samruddhashastry030/navic-sips/matlab/out/kpi_sweep_fixed.png

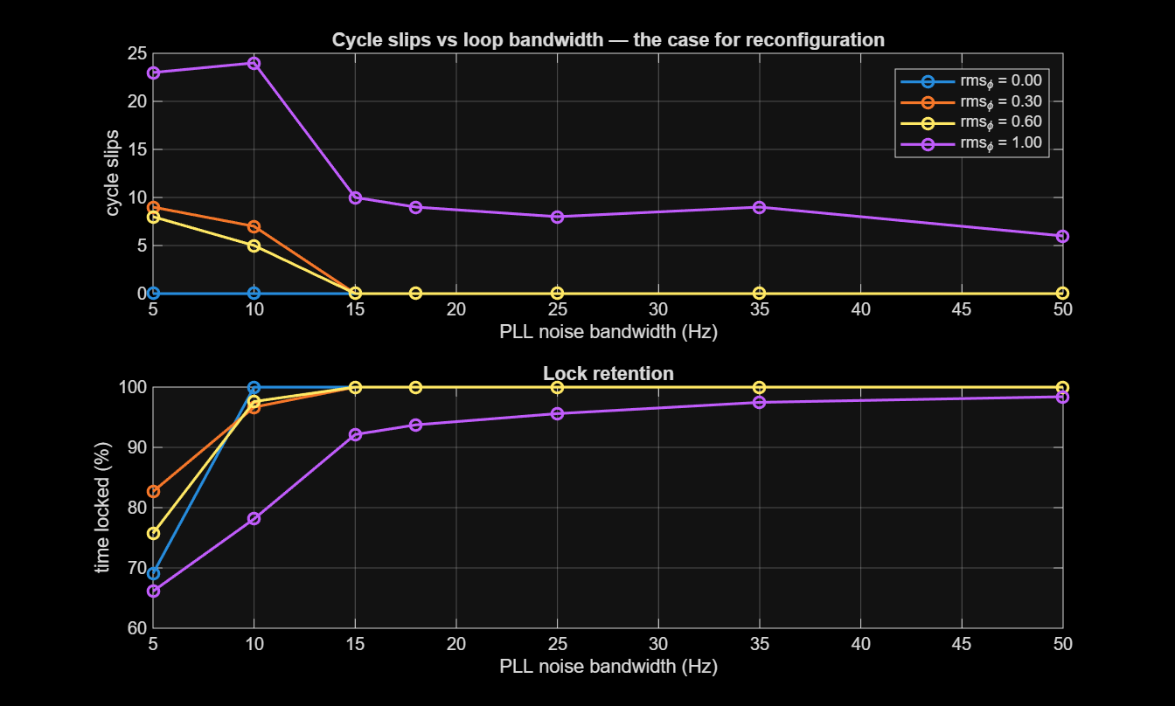
matlab/out/kpi_sweep_fixed.png
