samruddhashastry030/navic-sips/matlab/Q.png

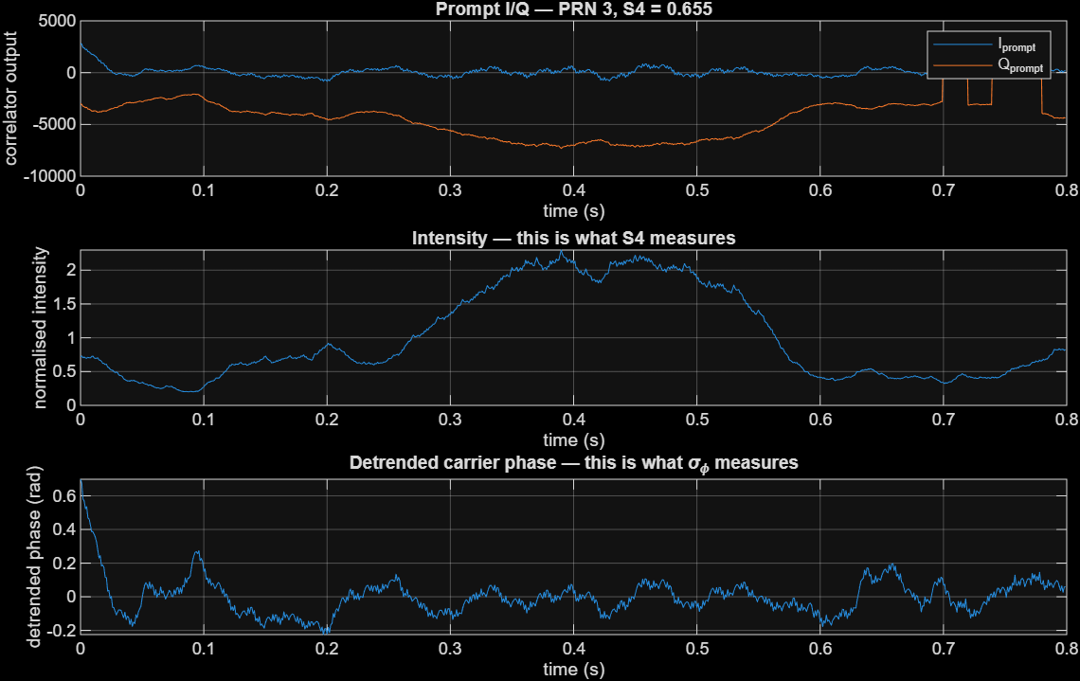
matlab/Q.png
