samruddhashastry030/navic-sips/matlab/out/kpi_results.csv

scint | bw | S4 | sigmaPhi | cycleSlips | lockFraction | meanCN0
0 | 5 | 0.0327298286688911 | 0.198362843854568 | 0 | 0.690666666666667 | 30.8938444919024
0 | 10 | 0.0327298286688877 | 0.11101728670671 | 0 | 1 | 33.5103716137767
0 | 15 | 0.0327298286688911 | 0.0923495164488063 | 0 | 1 | 33.6596927661663
0 | 18 | 0.0327298286688877 | 0.0837995596693963 | 0 | 1 | 33.6881438489789
0 | 25 | 0.0327298286688911 | 0.0630737580233704 | 0 | 1 | 33.7408337658369
0 | 35 | 0.0327298286688911 | 0.0431269650917404 | 0 | 1 | 33.7768762955005
0 | 50 | 0.0327298286688877 | 0.0340538441725248 | 0 | 1 | 33.7884648013822
0.3 | 5 | 0.330350867427098 | 0.389840134931066 | 9 | 0.826666666666667 | 30.9692741234643
0.3 | 10 | 0.330350867427096 | 0.245924950568542 | 7 | 0.966666666666667 | 32.3437781036556
0.3 | 15 | 0.330350867427096 | 0.146402988311347 | 0 | 1 | 32.935034015576
0.3 | 18 | 0.330350867427096 | 0.113757604458473 | 0 | 1 | 33.0636342401715
0.3 | 25 | 0.330350867427096 | 0.0742774789065409 | 0 | 1 | 33.1738159977029
0.3 | 35 | 0.330350867427095 | 0.05142006617363 | 0 | 1 | 33.2161570244355
0.3 | 50 | 0.330350867427097 | 0.0393446608640148 | 0 | 1 | 33.2320506783475
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
