samruddhashastry030/navic-sips/tb/system/tb_system_spi.sv

// tb_system_spi.sv -- the whole control and signal path as real RTL.
//
// Real PicoRV32, soc_bus, firmware, SICU, LSTM accelerator AND spi_master,
// which drives CS/SCLK/MOSI/MISO pins into a bit-level SPI flash model
// (mode 0, 0x03 READ, 24-bit address, auto-increment). Only the flash chip,
// the I/Q source and the SRAM macros are behavioural.
//
// Built with +define+BAD_FLASH it loads a corrupted image and checks the
// retry path at pin level: the flash must see three separately framed READ
// commands, which proves chip-select really rises between bursts.
//
// Earlier description, still applicable:
// tb_system_sicu.sv -- end-to-end run with the REAL SICU and REAL accelerator.
//
// The SICU is fed synthetic prompt I/Q: a slowly rotating carrier phase with
// amplitude scintillation whose depth ramps up window by window, so S4 climbs
// from quiet to disturbed. Each window's S4 is checked against S4 computed in
// floating point from the exact same integer samples.
//
// Otherwise as tb_system_accel.sv:
//
// Same as tb_system.sv, but the accelerator model is replaced by two copies of
// the verified lstm_accel:
//   u_acc  in the system: reads weights the CPU loaded over SPI into the
//          weight SRAM (port 1), fed timesteps by the firmware through soc_bus
//   u_ref  reference: reads the weight image straight from the file, fed the
//          identical timesteps on the identical cycles
// Both are the same RTL, already bit-exact against the golden vectors, so any
// difference in their logits can only come from integration.
//
// Real PicoRV32 (RV32IMC, as hardened), real soc_bus, real firmware from the
// boot ROM. Behavioural models stand in for:
//   - SPI flash      byte-level: answers each spi_start with the next byte
//   - SICU           pulses a new S4 every SICU_PERIOD cycles once enabled
//   - accelerator    accepts 32 timesteps, then returns fixed logits
// The SRAMs are modelled with a registered output like the SKY130 macros.
//
// Checks that the firmware boots, loads and verifies all 512 weight words,
// feeds the accelerator 32 correctly normalised timesteps in order, and
// publishes the class, loop settings and weights_ready it should.
`timescale 1ns/1ps
`default_nettype none
module tb_system_spi;
  localparam SICU_PERIOD = 4000;

  reg clk = 0, rst_n = 0;
  always #5 clk = ~clk;

  // ---- CPU ----------------------------------------------------------------
  wire        mem_valid, mem_instr, mem_ready, trap;
  wire [31:0] mem_addr, mem_wdata, mem_rdata;
  wire [ 3:0] mem_wstrb;

  picorv32 #(
    .ENABLE_MUL(1), .ENABLE_DIV(1), .COMPRESSED_ISA(1), .ENABLE_IRQ(1),
    .ENABLE_COUNTERS64(0),
    .PROGADDR_RESET(32'h0000_0000), .PROGADDR_IRQ(32'h0000_0010)
  ) u_cpu (
    .clk(clk), .resetn(rst_n), .trap(trap),
    .mem_valid(mem_valid), .mem_instr(mem_instr), .mem_ready(mem_ready),
    .mem_addr(mem_addr), .mem_wdata(mem_wdata), .mem_wstrb(mem_wstrb),
    .mem_rdata(mem_rdata),
    .mem_la_read(), .mem_la_write(), .mem_la_addr(), .mem_la_wdata(),
    .mem_la_wstrb(),
    .pcpi_valid(), .pcpi_insn(), .pcpi_rs1(), .pcpi_rs2(),
    .pcpi_wr(1'b0), .pcpi_rd(32'd0), .pcpi_wait(1'b0), .pcpi_ready(1'b0),
    .irq(32'd0), .eoi(), .trace_valid(), .trace_data()
  );

  // ---- bus + peripheral wires ---------------------------------------------
  wire dram_csb, dram_web, wram_csb, wram_web;
  wire [3:0] dram_wmask, wram_wmask; wire [7:0] dram_addr; wire [8:0] wram_addr;
  wire [31:0] dram_din, wram_din; reg [31:0] dram_dout = 0, wram_dout = 0;

  wire weights_ready, weights_fault, bist_done, bist_pass, loop_fll_en;
  wire [1:0] pred_class, loop_band_pref; wire [3:0] pred_conf;
  wire [2:0] loop_pll_bw, loop_t_coh; wire [15:0] s4_report;

  wire spi_start, spi_hold_cs; wire [7:0] spi_tx; reg [7:0] spi_rx;
  reg spi_done;
  wire uart_valid; wire [7:0] uart_data;

  wire sicu_enable; reg sicu_s4_valid; reg [15:0] sicu_s4;
  wire accel_start, accel_in_valid, accel_in_ready, accel_out_valid, accel_busy;
  wire [15:0] feat0, feat1;
  wire signed [15:0] l0, l1, l2; wire [1:0] acls;

  soc_bus #(.FW_HEX("firmware.hex")) u_bus (
    .clk_i(clk), .rst_ni(rst_n),
    .mem_valid_i(mem_valid), .mem_ready_o(mem_ready), .mem_addr_i(mem_addr),
    .mem_wdata_i(mem_wdata), .mem_wstrb_i(mem_wstrb), .mem_rdata_o(mem_rdata),
    .dram_csb_o(dram_csb), .dram_web_o(dram_web), .dram_wmask_o(dram_wmask),
    .dram_addr_o(dram_addr), .dram_din_o(dram_din), .dram_dout_i(dram_dout),
    .wram_csb_o(wram_csb), .wram_web_o(wram_web), .wram_wmask_o(wram_wmask),
    .wram_addr_o(wram_addr), .wram_din_o(wram_din), .wram_dout_i(wram_dout),
    .weights_ready_o(weights_ready), .weights_fault_o(weights_fault),
    .bist_done_o(bist_done), .bist_pass_o(bist_pass),
    .pred_class_o(pred_class), .pred_conf_o(pred_conf),
    .loop_pll_bw_o(loop_pll_bw), .loop_fll_en_o(loop_fll_en),
    .loop_t_coh_o(loop_t_coh), .loop_band_pref_o(loop_band_pref),
    .s4_report_o(s4_report), .host_ctrl_i(4'd0),
    .spi_start_o(spi_start), .spi_hold_cs_o(spi_hold_cs), .spi_tx_o(spi_tx),
    .spi_rx_i(spi_rx), .spi_done_i(spi_done),
    .uart_valid_o(uart_valid), .uart_data_o(uart_data), .uart_busy_i(1'b0),
    .sicu_enable_o(sicu_enable), .sicu_s4_valid_i(sicu_s4_valid),
    .sicu_s4_i(sicu_s4), .sicu_saturated_i(sicu_saturated_w),
    .sicu_shift_i(sicu_shift_w), .sicu_busy_i(sicu_busy_w),
    .accel_start_o(accel_start), .accel_busy_i(accel_busy),
    .accel_in_valid_o(accel_in_valid), .accel_in_ready_i(accel_in_ready),
    .accel_feat0_o(feat0), .accel_feat1_o(feat1),
    .accel_out_valid_i(accel_out_valid), .accel_logit0_i(l0),
    .accel_logit1_i(l1), .accel_logit2_i(l2), .accel_class_i(acls));

  // ---- SRAM models ---------------------------------------------------------
  reg [31:0] dmem [0:255], wmem [0:511];
  integer k;
  always @(posedge clk) begin
    if (!dram_csb) begin
      if (!dram_web) for (k = 0; k < 4; k = k + 1)
        begin if (dram_wmask[k]) dmem[dram_addr][8*k +: 8] <= dram_din[8*k +: 8]; end
      else dram_dout <= dmem[dram_addr];
    end
    if (!wram_csb) begin
      if (!wram_web) for (k = 0; k < 4; k = k + 1)
        begin if (wram_wmask[k]) wmem[wram_addr][8*k +: 8] <= wram_din[8*k +: 8]; end
      else wram_dout <= wmem[wram_addr];
    end
    if (!acc_w_csb) acc_w_dout <= wmem[acc_w_addr];      // port 1, read only
    if (!ref_w_csb) ref_w_dout <= refmem[ref_w_addr];
  end

  // ---- the real accelerator, and its reference twin ------------------------
  wire acc_w_csb, ref_w_csb; wire [8:0] acc_w_addr, ref_w_addr;
  reg  [31:0] acc_w_dout = 0, ref_w_dout = 0;
  reg  [31:0] refmem [0:511];
  initial $readmemh("wimage.hex", refmem);

  lstm_accel #(.LUT_SIG("lut_sigmoid.hex"), .LUT_TANH("lut_tanh.hex")) u_acc (
    .clk_i(clk), .rst_ni(rst_n),
    .start_i(accel_start), .busy_o(accel_busy),
    .in_valid_i(accel_in_valid), .in_ready_o(accel_in_ready),
    .in_feat0_i(feat0), .in_feat1_i(feat1),
    .w_csb_o(acc_w_csb), .w_addr_o(acc_w_addr), .w_dout_i(acc_w_dout),
    .out_valid_o(accel_out_valid),
    .logit0_o(l0), .logit1_o(l1), .logit2_o(l2), .class_o(acls));

  wire ref_ready, ref_valid, ref_busy; wire signed [15:0] r0, r1, r2; wire [1:0] rcls;
  lstm_accel #(.LUT_SIG("lut_sigmoid.hex"), .LUT_TANH("lut_tanh.hex")) u_ref (
    .clk_i(clk), .rst_ni(rst_n),
    .start_i(accel_start), .busy_o(ref_busy),
    .in_valid_i(accel_in_valid), .in_ready_o(ref_ready),
    .in_feat0_i(feat0), .in_feat1_i(feat1),
    .w_csb_o(ref_w_csb), .w_addr_o(ref_w_addr), .w_dout_i(ref_w_dout),
    .out_valid_o(ref_valid),
    .logit0_o(r0), .logit1_o(r1), .logit2_o(r2), .class_o(rcls));

  // ---- REAL SPI master ------------------------------------------------------
  // clk_div 1: SCLK = clk / 4 -- 8.25 MHz at 33 MHz, well inside what any
  // flash part supports for a plain 0x03 READ.
  wire spi_cs_n, spi_sclk, spi_mosi, spi_miso;
  wire spi_busy_w;
  wire [7:0] spi_rx_w; wire spi_done_w;
  spi_master #(.DIV_WIDTH(8), .DATA_WIDTH(8)) u_spi (
    .clk_i(clk), .rst_ni(rst_n), .clk_div_i(8'd1),
    .start_i(spi_start), .hold_cs_i(spi_hold_cs), .tx_data_i(spi_tx),
    .rx_data_o(spi_rx_w), .busy_o(spi_busy_w), .done_o(spi_done_w),
    .cs_no(spi_cs_n), .sclk_o(spi_sclk), .mosi_o(spi_mosi), .miso_i(spi_miso));
  always @(*) begin spi_rx = spi_rx_w; spi_done = spi_done_w; end

  integer n_spi = 0;
  always @(posedge clk) if (spi_start) n_spi = n_spi + 1;

  // ---- bit-level SPI flash: mode 0, 0x03 READ, full 24-bit address ----------
  // Structure follows tb/tb_spi_master.sv; extended from 256 bytes to the full
  // image, and it counts every command so framing can be checked.
  reg [7:0]  flash [0:4095];
  reg [7:0]  f_shift_in, f_shift_out;
  reg [2:0]  f_bitcnt;
  reg [7:0]  f_cmd;
  reg [23:0] f_addr;
  reg [2:0]  f_state;           // 0 cmd, 1..3 addr, 4 data
  reg        f_miso;
  integer    n_cmd = 0, n_bad_cmd = 0, n_cs_fall = 0;
  assign spi_miso = spi_cs_n ? 1'bz : f_miso;
  initial begin
    for (k = 0; k < 4096; k = k + 1) flash[k] = 8'hFF;
`ifdef BAD_FLASH
    $readmemh("flash_bad.hex", flash);
`else
    $readmemh("flash.hex", flash);
`endif
  end
  always @(negedge spi_cs_n) begin
    f_bitcnt <= 0; f_state <= 0; f_shift_in <= 0; f_miso <= 1'b0;
    n_cs_fall = n_cs_fall + 1;
  end
  always @(posedge spi_sclk) if (!spi_cs_n) begin
    f_shift_in <= {f_shift_in[6:0], spi_mosi};
    if (f_bitcnt == 3'd7) begin
      case (f_state)
        3'd0: begin
          f_cmd <= {f_shift_in[6:0], spi_mosi}; f_state <= 1;
          n_cmd = n_cmd + 1;
          if ({f_shift_in[6:0], spi_mosi} !== 8'h03) n_bad_cmd = n_bad_cmd + 1;
        end
        3'd1: begin f_addr[23:16] <= {f_shift_in[6:0], spi_mosi}; f_state <= 2; end
        3'd2: begin f_addr[15:8]  <= {f_shift_in[6:0], spi_mosi}; f_state <= 3; end
        3'd3: begin f_addr[7:0]   <= {f_shift_in[6:0], spi_mosi}; f_state <= 4; end
        default: f_addr <= f_addr + 1;
      endcase
      f_bitcnt <= 0;
    end else f_bitcnt <= f_bitcnt + 1;
  end
  always @(negedge spi_sclk) if (!spi_cs_n) begin
    if (f_state == 4) begin
      if (f_bitcnt == 0) begin
        f_shift_out <= flash[f_addr[11:0]];
        f_miso      <= flash[f_addr[11:0]][7];
      end else f_miso <= f_shift_out[6-(f_bitcnt-1)];
    end else f_miso <= 1'b0;
  end

  // ---- REAL SICU, fed synthetic I/Q --------------------------------------
  localparam SAMPLE_GAP = 8;          // cycles between samples offered
  localparam WIN_N      = 500;

  reg  signed [15:0] iq_i = 0, iq_q = 0;
  reg                iq_valid = 0;
  wire               iq_ready, sicu_saturated_w, sicu_busy_w, sicu_s4_valid_w;
  wire        [15:0] sicu_s4_w;
  wire        [ 4:0] sicu_shift_w;

  sicu u_sicu (
    .clk_i(clk), .rst_ni(rst_n), .enable_i(sicu_enable), .busy_o(sicu_busy_w),
    .in_valid_i(iq_valid), .in_ready_o(iq_ready), .i_i(iq_i), .q_i(iq_q),
    .s4_valid_o(sicu_s4_valid_w), .s4_o(sicu_s4_w),
    .saturated_o(sicu_saturated_w), .shift_o(sicu_shift_w));

  // Deterministic pseudo-random scintillation. Depth d ramps per window;
  // amplitude a = A * (1 + d * r), r uniform in [-1, 1).
  reg  [31:0] lfsr = 32'hACE1_2468;
  integer     gap = 0, n_samp = 0, n_windows = 0, cyc_w32 = 0;
  real        amp, phase = 0.0, depth, r, inten, s1 = 0, s2 = 0;
  real        s4_ref [0:63];
  reg  [15:0] s4_hw  [0:63];
  reg         sat_hw [0:63];
  reg  [ 4:0] shf_hw [0:63];

  always @(posedge clk) begin
    if (iq_valid && iq_ready) begin
      // accumulate the float reference on exactly the samples accepted
      inten = $itor(iq_i) * $itor(iq_i) + $itor(iq_q) * $itor(iq_q);
      s1 = s1 + inten; s2 = s2 + inten * inten;
      n_samp = n_samp + 1;
      if (n_samp == WIN_N) begin
        if (n_windows < 64)
          s4_ref[n_windows] = $sqrt((WIN_N * s2) / (s1 * s1) - 1.0);
        s1 = 0; s2 = 0; n_samp = 0;
      end
      iq_valid <= 0;
      gap = 0;
    end else if (!iq_valid && sicu_enable) begin
      gap = gap + 1;
      if (gap >= SAMPLE_GAP) begin
        lfsr  = {lfsr[30:0], lfsr[31] ^ lfsr[21] ^ lfsr[1] ^ lfsr[0]};
        r     = ($itor(lfsr[15:0]) / 32768.0) - 1.0;
        depth = 0.02 + 0.010 * n_windows;
        amp   = 1200.0 * (1.0 + depth * r);
        phase = phase + 0.013;
        iq_i  <= $rtoi(amp * $cos(phase));
        iq_q  <= $rtoi(amp * $sin(phase));
        iq_valid <= 1;
      end
    end
    if (sicu_s4_valid_w) begin
      if (n_windows < 64) begin
        s4_hw[n_windows]  = sicu_s4_w;
        sat_hw[n_windows] = sicu_saturated_w;
        shf_hw[n_windows] = sicu_shift_w;
      end
      n_windows = n_windows + 1;
      if (n_windows == 32) cyc_w32 = cyc;
    end
  end

  // Feed the bus from the real block.
  always @(*) begin
    sicu_s4_valid = sicu_s4_valid_w;
    sicu_s4       = sicu_s4_w;
  end

  // ---- record what the firmware feeds, and when each accelerator finishes --
  integer n_feat = 0, n_starts = 0, lockstep_err = 0;
  reg [15:0] got_feat [0:31];
  reg signed [15:0] sys_l [0:2], ref_l [0:2];
  reg sys_done = 0, ref_done = 0;
  always @(posedge clk) begin
    if (accel_start) n_starts = n_starts + 1;
    if (accel_in_valid && accel_in_ready) begin
      if (n_feat < 32) got_feat[n_feat] = feat0;
      n_feat = n_feat + 1;
    end
    if (accel_in_ready !== ref_ready) lockstep_err = lockstep_err + 1;
    if (accel_out_valid && !sys_done) begin
      sys_l[0] = l0; sys_l[1] = l1; sys_l[2] = l2; sys_done = 1;
    end
    if (ref_valid && !ref_done) begin
      ref_l[0] = r0; ref_l[1] = r1; ref_l[2] = r2; ref_done = 1;
    end
  end

  // ---- checks -------------------------------------------------------------
  integer errors = 0, cyc = 0;
  reg [31:0] wexp [0:511];
  // mu and 1/sd come from the header of the image under test, not constants:
  // the real exported weights carry different values from any test image.
  integer mu_g, invsd_g;
  function automatic signed [15:0] norm(input [15:0] s4);
    integer q88, d, o;
    begin
      q88 = (s4 + 8) >>> 4;
      d   = q88 - mu_g;
      o   = (d * invsd_g + 128) >>> 8;
      if (o >  32767) o =  32767;
      if (o < -32768) o = -32768;
      norm = o[15:0];
    end
  endfunction

  always @(posedge clk) begin
    cyc = cyc + 1;
    if (trap) begin
      $display("FAIL  CPU trapped at cycle %0d, pc near %h", cyc, mem_addr);
      errors = errors + 1; $finish;
    end
  end

`ifndef BAD_FLASH
  initial begin
    $readmemh("wimage.hex", wexp);
    mu_g    = $signed(wexp[0][15:0]);
    invsd_g = $signed(wexp[1][15:0]);
    $display("       header: mu = %0d/256, 1/sd = %0d/256", mu_g, invsd_g);
    repeat (5) @(posedge clk); rst_n = 1;

    wait (sicu_enable === 1'b1);
    $display("cycle %0d  firmware reached the main loop (%0d SPI bytes)", cyc, n_spi);
    for (k = 0; k < 512; k = k + 1)
      if (wmem[k] !== wexp[k]) begin
        if (errors < 5) $display("FAIL  weight word %0d: %h != %h", k, wmem[k], wexp[k]);
        errors = errors + 1;
      end
    if (errors == 0) $display("pass  all 512 weight words loaded and match");
    $display("       flash saw %0d command(s), %0d CS falls, %0d not 0x03", n_cmd, n_cs_fall, n_bad_cmd);
    if (n_cmd != 1 || n_bad_cmd != 0 || f_addr === 24'hx) begin
      $display("FAIL  expected exactly one 0x03 READ"); errors = errors + 1;
    end else $display("pass  one framed 0x03 READ, burst of %0d bytes on the pins", n_spi - 4);
    if (weights_fault) begin $display("FAIL  firmware reported weight fault"); errors = errors + 1; end
    else $display("pass  checksum accepted, no fault");
    if (weights_ready) begin $display("FAIL  ready asserted before first result"); errors = errors + 1; end
    else $display("pass  not ready during cold start");

    wait (weights_ready === 1'b1);
    $display("cycle %0d  first result published", cyc);
    $display("       inference latency: %0d cycles from the 32nd window to the result", cyc - cyc_w32);
    $display("       = %0.2f ms at 33 MHz, against a 10 s window", (cyc - cyc_w32) / 33000.0);
    if (n_windows < 32) begin $display("FAIL  result before 32 windows"); errors = errors + 1; end
    if (n_starts != 1)   begin $display("FAIL  %0d accelerator starts", n_starts); errors = errors + 1; end
    begin : sicu_checks
      integer w, worst_w, n_sat;
      real err, worst;
      reg [15:0] pushed [0:31];
      reg [15:0] last;
      worst = 0.0; worst_w = 0; n_sat = 0; last = 0;
      $display("       window  shift  sat   S4 hw    S4 float   error");
      begin : ring
        integer np;
        np = 0;
        for (w = 0; w < 64 && np < 32; w = w + 1) begin
          if (w < 4 || w % 8 == 7)
            $display("       %4d    %3d    %0d   %6.4f   %6.4f   %+7.4f", w, shf_hw[w],
                     sat_hw[w], s4_hw[w] / 4096.0, s4_ref[w], s4_hw[w] / 4096.0 - s4_ref[w]);
          if (sat_hw[w]) n_sat = n_sat + 1;
          else begin
            err = s4_hw[w] / 4096.0 - s4_ref[w]; if (err < 0) err = -err;
            if (err > worst) begin worst = err; worst_w = w; end
          end
          // firmware policy: drop a saturated window with no history,
          // otherwise carry the previous value forward
          if (sat_hw[w] && np == 0) ;
          else begin
            pushed[np] = sat_hw[w] ? last : s4_hw[w];
            last = pushed[np];
            np = np + 1;
          end
        end
      end
      $display("       %0d windows saturated before the ring filled", n_sat);
      $display("       worst unsaturated S4 error vs float: %0.4f (window %0d)", worst, worst_w);
      if (worst > 0.02) begin
        $display("FAIL  SICU S4 off by more than 0.02"); errors = errors + 1;
      end else $display("pass  SICU S4 within 0.02 of float on every unsaturated window");
      for (k = 0; k < 32; k = k + 1)
        if (got_feat[k] !== norm(pushed[k])) begin
          if (errors < 8) $display("FAIL  timestep %0d fed %h, expected %h", k, got_feat[k], norm(pushed[k]));
          errors = errors + 1;
        end
    end
    $display("%s  32 timesteps normalised correctly and fed oldest-first",
             (errors == 0) ? "pass" : "    ");
    $display("       accelerator started %0d time(s), took %0d timesteps", n_starts, n_feat);
    if (lockstep_err) begin
      $display("FAIL  system and reference accelerators left lockstep (%0d cycles)", lockstep_err);
      errors = errors + 1;
    end else $display("pass  system and reference accelerators stayed in lockstep");
    if (!sys_done || !ref_done) begin
      $display("FAIL  an accelerator never finished"); errors = errors + 1;
    end
    $display("       system    logits  %6d %6d %6d", sys_l[0], sys_l[1], sys_l[2]);
    $display("       reference logits  %6d %6d %6d", ref_l[0], ref_l[1], ref_l[2]);
    if (sys_l[0] !== ref_l[0] || sys_l[1] !== ref_l[1] || sys_l[2] !== ref_l[2]) begin
      $display("FAIL  logits differ -- integration corrupted weights or timesteps");
      errors = errors + 1;
    end else $display("pass  logits bit-identical to the reference");
    begin : expect_class
      integer ru, ec, m, ec_conf;
      ru = (sys_l[0] > sys_l[1]) ? sys_l[0] : sys_l[1];
      if (sys_l[2] - ru >= 64) begin ec = 2; m = sys_l[2] - ru; end
      else if (sys_l[1] > sys_l[0]) begin
        ec = 1; m = sys_l[1] - ((sys_l[0] > sys_l[2]) ? sys_l[0] : sys_l[2]);
      end else begin
        ec = 0; m = sys_l[0] - ((sys_l[1] > sys_l[2]) ? sys_l[1] : sys_l[2]);
      end
      ec_conf = m >>> 6; if (ec_conf > 15) ec_conf = 15; if (ec_conf < 0) ec_conf = 0;
      if (pred_class !== ec[1:0]) begin
        $display("FAIL  firmware published class %0d, margin rule gives %0d", pred_class, ec);
        errors = errors + 1;
      end else $display("pass  firmware's class %0d matches the margin rule on real logits", pred_class);
      if (pred_conf !== ec_conf[3:0]) begin
        $display("FAIL  confidence %0d, expected %0d", pred_conf, ec_conf);
        errors = errors + 1;
      end else $display("pass  confidence %0d", pred_conf);
    end
    $display("       latest S4 reported to host: %0.4f", s4_report / 4096.0);

    $display("");
    if (errors == 0) $display("PASS: system -- firmware boots, loads, infers, publishes");
    else             $display("FAIL: system -- %0d errors", errors);
    $finish;
  end

`else
  initial begin
    repeat (5) @(posedge clk); rst_n = 1;
    wait (weights_fault === 1'b1);
    $display("cycle %0d  weights_fault after %0d SPI bytes", cyc, n_spi);
    $display("       flash saw %0d command(s) over %0d CS falls, %0d not 0x03",
             n_cmd, n_cs_fall, n_bad_cmd);
    if (n_cmd == 3 && n_cs_fall == 3 && n_bad_cmd == 0)
      $display("pass  three separately framed READs -- CS rises between retries");
    else begin $display("FAIL  retry framing"); errors = errors + 1; end
    repeat (50000) @(posedge clk);
    if (weights_ready || sicu_enable) begin $display("FAIL  left the safe state"); errors = errors + 1; end
    else $display("pass  stays not-ready and never starts measuring");
    if (spi_cs_n !== 1'b1) begin $display("FAIL  CS left low after giving up"); errors = errors + 1; end
    else $display("pass  CS released after giving up");
    if (errors == 0) $display("PASS: SPI fault path at pin level");
    else             $display("FAIL: SPI fault path, %0d errors", errors);
    $finish;
  end
`endif

  initial begin #40_000_000; $display("FAIL: timeout at cycle %0d", cyc); $finish; end
endmodule
`default_nettype wire
