samruddhashastry030/navic-sips/(commit log)

2026-07-27 Stage A: toolchain bring-up, uart_tx + cocotb testbench
2026-08-18 LibreLane SKY130 flow: uart_tx to clean GDSII, DRC/LVS pass
2026-08-22 MATLAB chain: NavIC L5 waveform -> tracker -> prompt I/Q; scintillation validated S4 0.013 -> 0.655
    [prompt_iq.csv]
2026-08-23 KPI experiment: optimum PLL bandwidth shifts 5->50 Hz with scintillation; lock retention 66%->98% at S4 0.81
    [kpi_results.csv]
2026-08-23 SPI master with Flash-read verification; KPI sweep results
2026-08-23 Fix Verilator width warning; lint per-file; add plain-Verilog TBs to CI
    [spi_master.sv]
2026-09-10 Top level, SICU flow config, gitignore for build artifacts
2026-09-11 Firmware flow spec and integration interface contracts
2026-09-20 Accelerator: replace LUT index multiply with shifts; -21k um2, -71% power
    [lstm_accel.sv]
2026-09-21 Accelerator hardened with one shared multiplier: -41% area, -73% power
2026-09-22 Firmware: boot, SPI weight load, inference loop; 836 bytes, fits 1 KB ROM
2026-09-22 Real SICU in the system test; fix firmware pushing the saturated first window
    [main.c, tb_system_sicu.sv]
2026-09-22 Full chip as real RTL in simulation: SPI master on pins, retry framing verified
2026-09-22 Real top level, no stubs; chip at its pins classifies sustained S4 0.87 as SEVERE and raises the host interrupt
2026-09-22 Pipeline accelerator gate lookups for whole-chip ss setup; over-fix hold on host inputs; skip Magic DRC
    [lstm_accel.sv]
2026-09-22 Reset synchroniser: async assert, sync release; tighten implementation clock to 27 ns
    [navic_sips_top.sv]
2026-09-23 Whole chip signs off: setup +1.76ns, hold +0.94ns, DRC/LVS/antenna clean at density 45
2026-10-07 Whole-chip signoff with weight-scrubbing firmware, hold margin 0.75
    Resumed from post-CTS state of RUN_2026-10-07_14-35-20.
    Setup +3.741 ns (max_ss), hold +0.381 ns (max_ss) / +0.103 ns (min_ff),
    KLayout DRC/LVS/route DRC/antenna 0, slew/cap 1025/133, 40.7 uW.
2026-10-08 Post-GRT slew repair + antenna diodes; new signoff run RUN_scrub_075_ant
    Settings: RUN_POST_GRT_DESIGN_REPAIR, RUN_HEURISTIC_DIODE_INSERTION,
    DRT_ANTENNA_REPAIR_ITERS=10; drop unused GRT_RESIZER_HOLD_SLACK_MARGIN.
    Setup +3.217 ns (max_ss), hold +0.104 ns (min_ff) / +0.237 ns (max_ss),
    KLayout DRC/LVS/route DRC/antenna 0, slew/cap 865/79 (was 1025/133), 41.0 uW.
2026-10-12 Hierarchical layout option: CPU, accelerator and SICU as hardened macros
    - rtl/cpu_core.sv: PicoRV32 RV32IMC with its parameters fixed inside and
    only the native memory bus exposed (104 pins instead of ~400).
    - rtl/acc_core.sv: lstm_accel wrapper; LUT paths are baked in when the
    macro is hardened, so the chip build (NAVIC_HIER) instantiates it
    without parameters.
    - navic_sips_top.sv uses both wrappers. Behaviour unchanged: pin-level
    chip test and weight-scrub test give identical logits and cycle counts
    to the previous RTL.
    - flow/librelane/hier/make_configs.py writes the three macro configs
    (fixed rectangles, met4-only power and routing, pins on the side facing
    their neighbours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
2026-10-12 hier: SICU I/Q inputs get the 2 ns pin budget, not 8 ns
2026-10-12 hier: place macros on the routing-track grid (fixes 3 m2.2 at acc_core pins)
2026-10-12 Hierarchical chip signs off: DRC/LVS/antenna 0, macros on routing grid
2026-10-14 Experiments: accelerator vs CPU software, SKY130 vs ASAP7
    Asked for at the 14 Oct mentor review.
    - fw/lstm_sw.c: the LSTM in C, bit-exact with lstm_accel.sv on all 64
    golden vectors (int64, and int32 for weight images with |w| < 14.2,
    checked at boot). Only built with -DSW_LSTM; the shipping firmware
    image is byte-identical.
    - sw_vs_accel/: cycles per forecast on the full chip RTL. Accelerator
    101,100; software 2.34M-4.53M depending on CPU multiplier, accumulator
    and -O level. Pin-level run of the software build publishes the same
    result as the accelerator build.
    - node_compare/: same RTL synthesised against SKY130 HD and ASAP7 RVT
    (tt), with area, gate delay, leakage and an e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
2026-10-14 Correct the chip power figure: ~36 mW, not 39.5 uW
    The post-route power report of RUN_hier2 (nom_tt_025C_1v80) gives
    36.5 mW total with default activity: clock tree 4.4 mW, flip-flops
    5.0 mW, combinational 24.2 mW, macros 2.9 mW, leakage 28 uW. The
    39.5 uW previously in docs/chip-results.md matched no report.
    Claude-Session: https://claude.ai/code/session_01WLDS8YabSvnoaMTsYxyUaX
2026-10-14 Clock-gate the LSTM accelerator
    The accelerator works ~101,000 cycles out of every ~303 million (one
    forecast per 10 s) but its 1,122 flip-flops were clocked on every cycle.
    acc_core now runs it on a gated clock, enabled by reset, the start pulse,
    busy, and out_valid (one more edge so out_valid clears).
    Silicon uses sky130_fd_sc_hd__dlclkp_2 (SKY130_ICG, set in both the
    hierarchical acc_core macro config and the flat chip config); simulation
    uses the same latch-and-AND behaviour.
    Verified:
    - tb/accel/run.sh (new): golden logits on two runs separated by 5,000
    idle cycles; gated clock stops within 2 cycles of the result and stays
    stopped; no glitches. Shown to fail with out_valid dropped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
2026-10-14 Gate-level simulation and measured power for the accelerator macro
    tb/gls/acc/run.sh runs tb/accel/tb_acc_clock_gate.sv against the hardened
    acc_core netlist (flow/librelane/hier/acc_core/runs/$RUN/final/nl) with
    the SKY130 HD cell models, at the chip's 33 ns clock, 0.1 ns unit delay.
    With 'power' it records switching activity for 10,000 cycles mid-forecast
    and 10,000 idle cycles, and runs OpenSTA report_power on each (tt corner,
    SPEF if present).
    The testbench gains GLS (netlist has no parameters), HALF_NS, and the
    +vcd_active / +vcd_idle activity windows; RTL behaviour is unchanged.
    Checked here on a Yosys-synthesised acc_core netlist (SKY130_ICG, real
    dlclkp_2 cell model): all checks pa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
2026-10-16 GLS power: read the macro's .odb so OpenROAD has the technology
    OpenROAD stopped with ORD-2010 (no technology read) at read_verilog.
    The power step now loads final/odb/acc_core.odb, which carries the
    technology, cells and netlist, and shows OpenROAD's error if it fails
    instead of filtering it away.
    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
2026-10-16 Firmware tunables from the flash image, not the ROM
    The SEVERE logit margin, the confidence shift and the three loop-setting
    codes were constants in the boot ROM, which is frozen at tape-out. A
    retrained model needs a new margin (derive_margin.py), and the loop codes
    still wait on the receiver interface. Both would have meant a re-spin.
    They now come from a config block in the weight image's padding, slots
    992-998 (tag 0xC0F1, version 1), written by python/ml/config_block.py and
    by export_weights.py. An image without the block runs on built-in
    defaults, which are the shipping values. The block is covered by the
    image checksum and the SRAM scrub, and re-read after every reload.
    The firmware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
2026-10-16 Whole-chip gate-level simulation
    tb/gls/chip/run.sh runs the pin-level chip test (tb/top/tb_top.sv) on the
    hierarchical layout's netlists: the chip top from
    flow/librelane/hier/navic_sips_top/runs/$RUN (default RUN_hier4) and the
    cpu_core, acc_core and sicu macros from runs/$MACRO_RUN (RUN_macro),
    with the SKY130 HD functional models and tb/top/sram_models.sv.
    The functional models put the 0.1 ns UNIT_DELAY on flip-flops and latches
    only; gates and clock buffers are zero delay. So clock trees and the
    accelerator's clock gate cannot race the data, and the run checks
    function on the real netlist. Timing is left to STA.
    tb_top.sv gains GLS mode: it instantiates the netlist without parameters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
2026-10-16 chip-results: hierarchical signoff, gate-level results, measured power
    Brings docs/chip-results.md up to date with RUN_hier4 (DRC/LVS/antenna
    0, setup +3.32 ns, hold +0.096 ns), the accelerator and whole-chip
    gate-level simulations (both pass; the chip's matches RTL), the measured
    accelerator power (3.28 mW computing, 66 uW idle, ~11 uJ per forecast),
    the keep-and-clock-gate decision, and the remaining work. Notes that the
    old tb/system suite is stale.
    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
2026-10-16 Datasheet for rev 1
    docs/datasheet.md: pins, host bus, register map with bit fields, I/Q
    input, start-up, the per-window sequence, fail-safes, and the flash image
    format including the config block, all taken from the RTL and firmware.
    It also records rev 1 gaps found while writing it:
    - CTRL.ENABLE and CTRL.BIST do nothing: the firmware never reads the host
    control bits, and BIST_DONE/BIST_PASS never set
    - sigma-phi is tied to 0
    - the UART is unused, and its divisor assumes 33 MHz while the chip runs
    at 30.3 MHz (33 ns), about 8% off
    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
